Lasan-Perera/Fully-Analogue-Line-Follower-EN2091-/Final Schemetic.pdf

# LEFT PWM

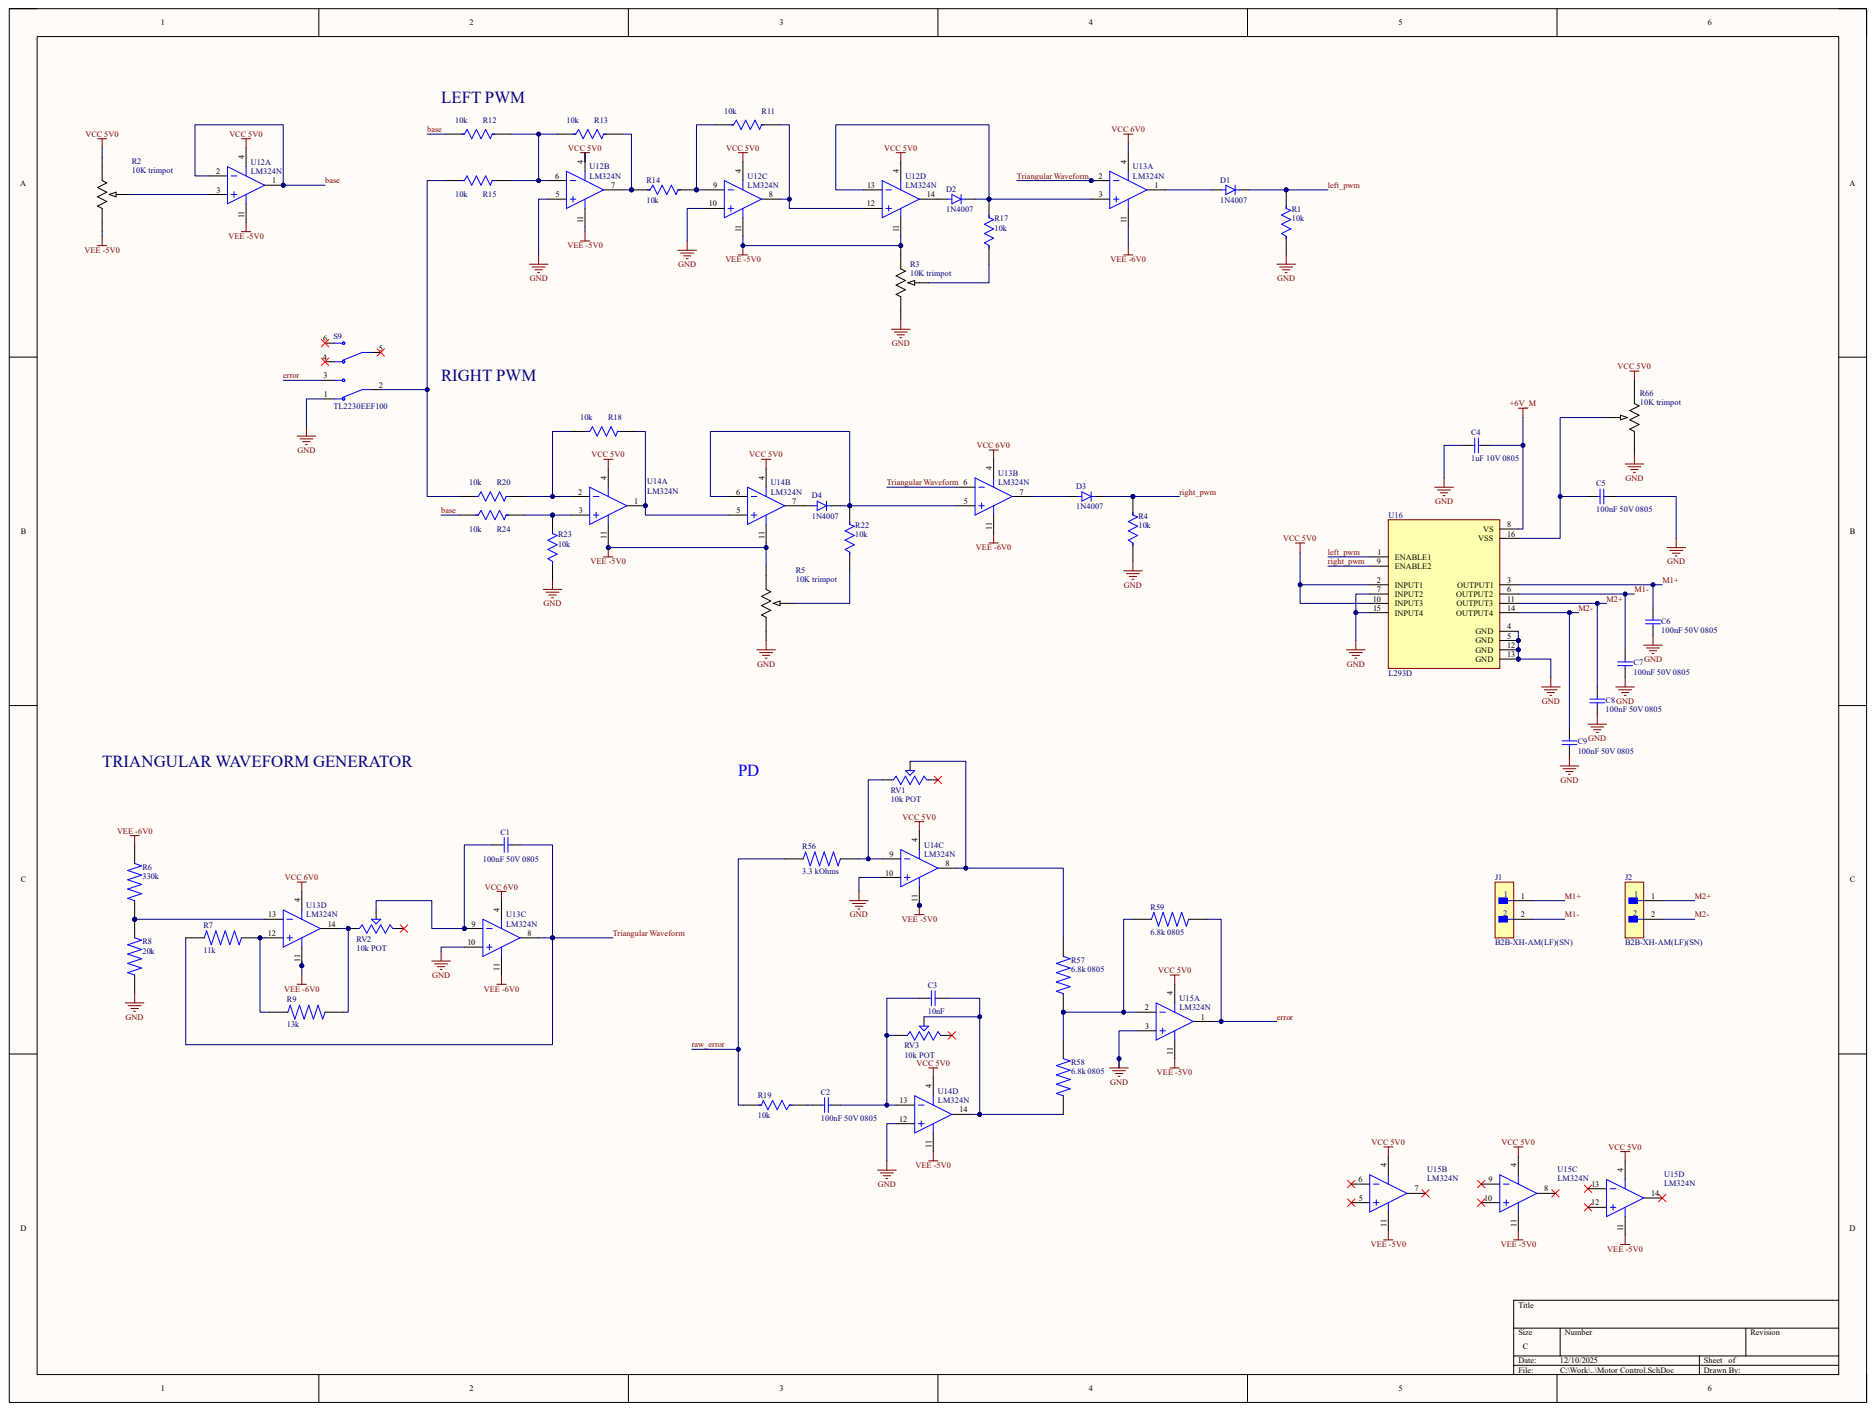
[picture p1: page 1]

A A

IN 1 | OUT | 3

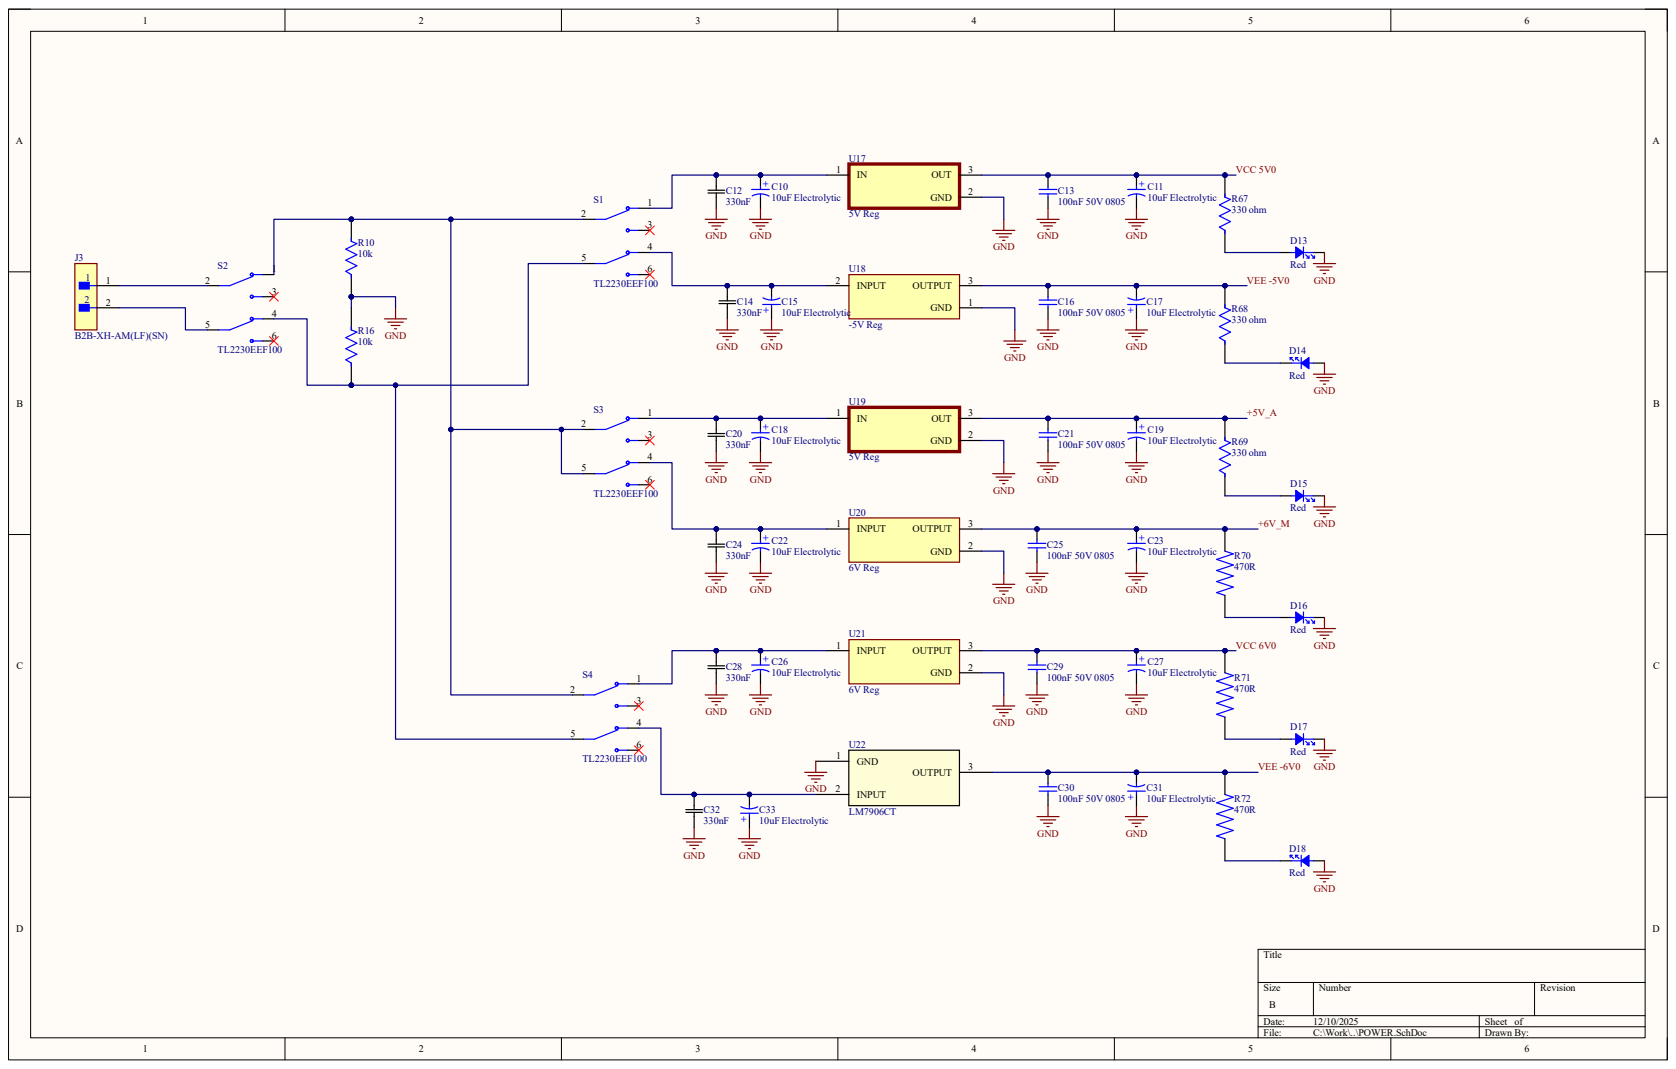
[picture p2: page 2]

# SENSOR PANEL +

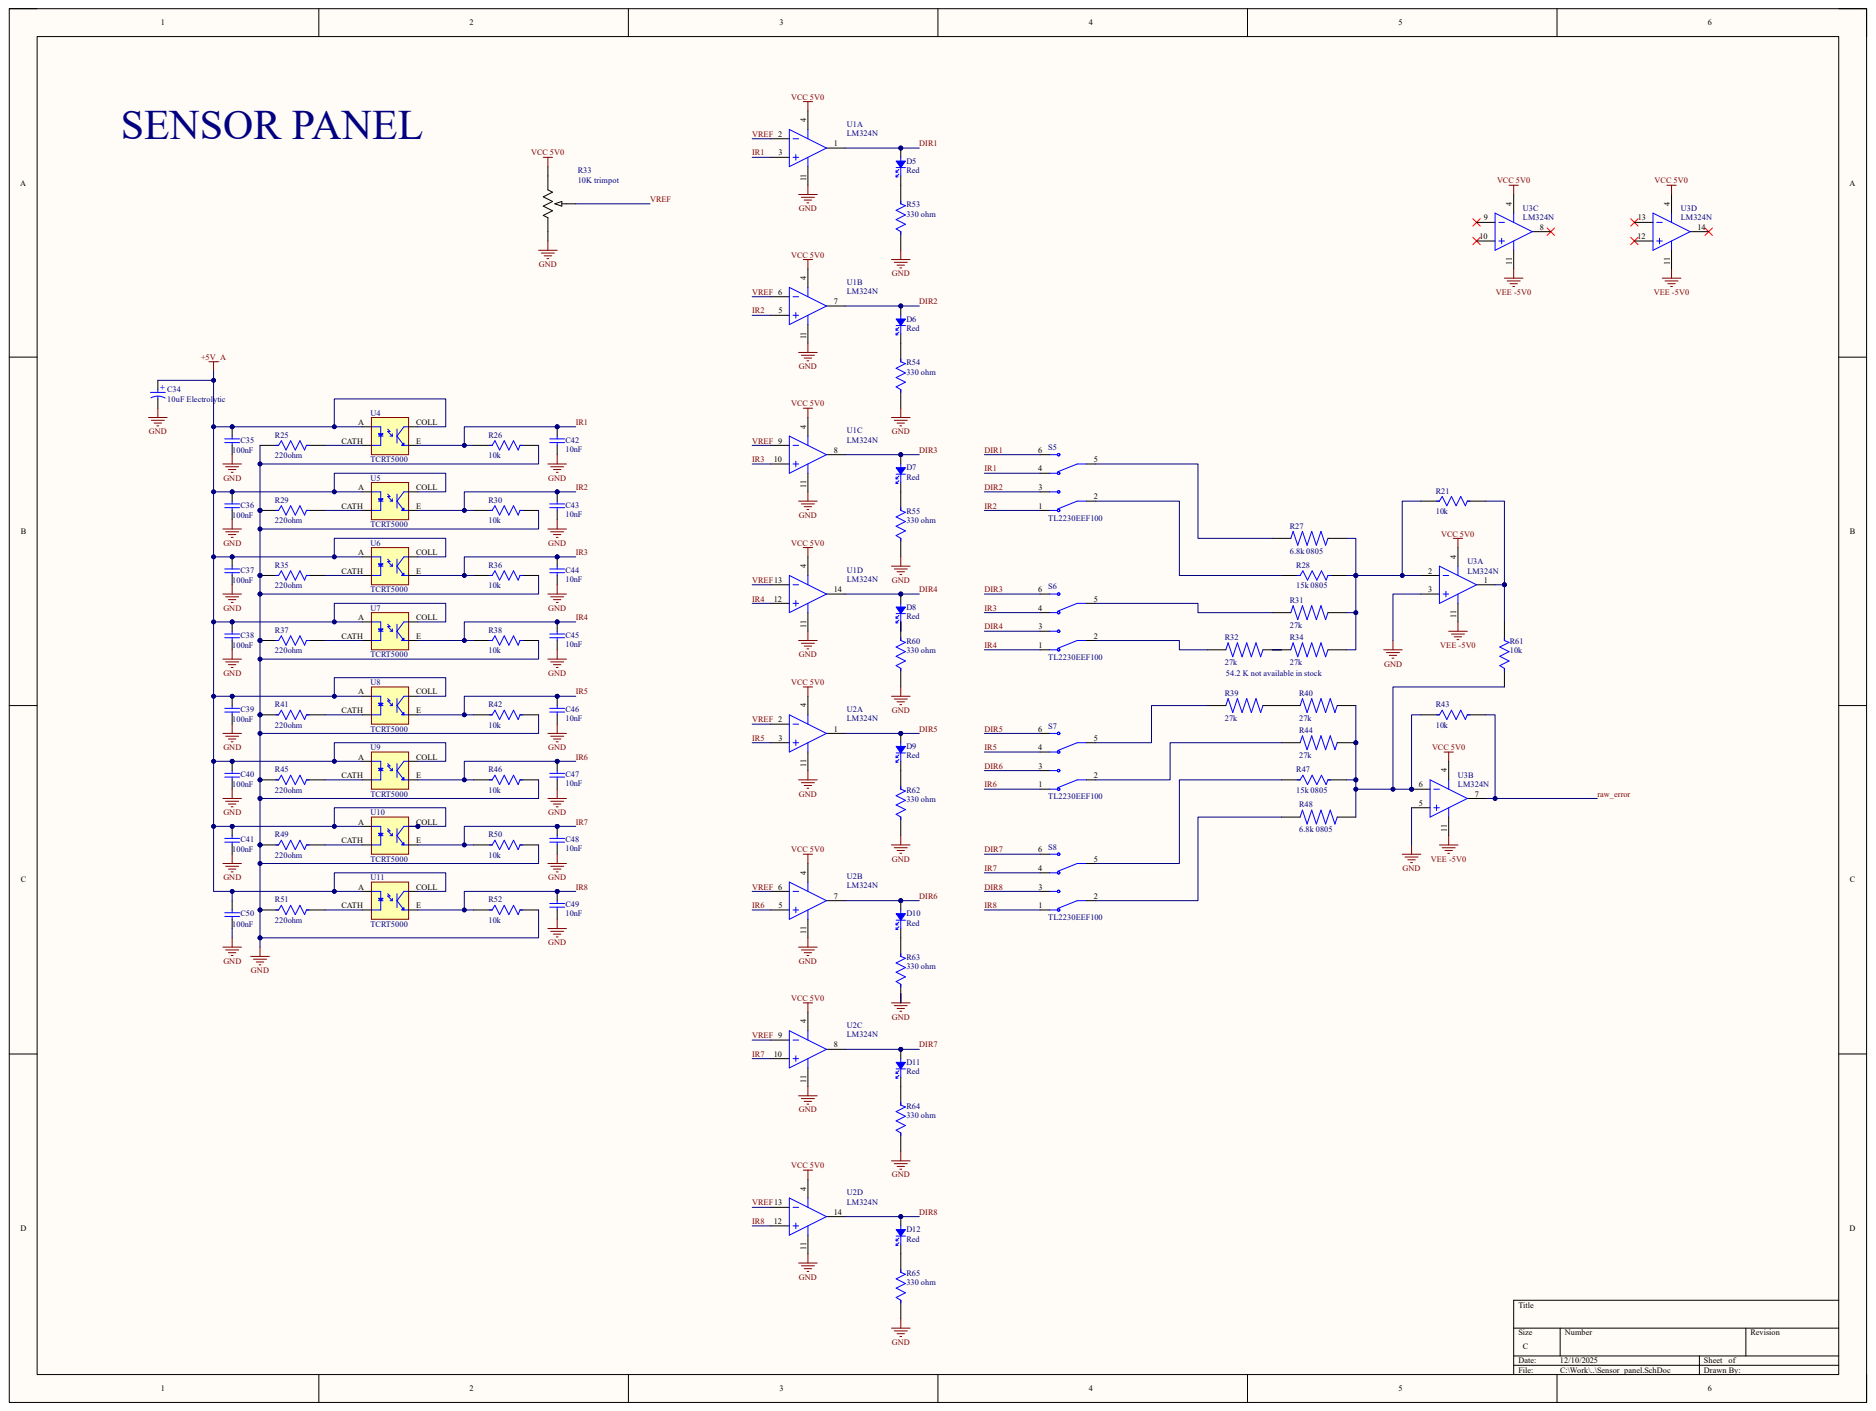
[picture p3: page 3]

54.2 K not available in stock
