Lasan-Perera/Fully-Analogue-Line-Follower-EN2091-/Simulations/Sensor Panel.pdf

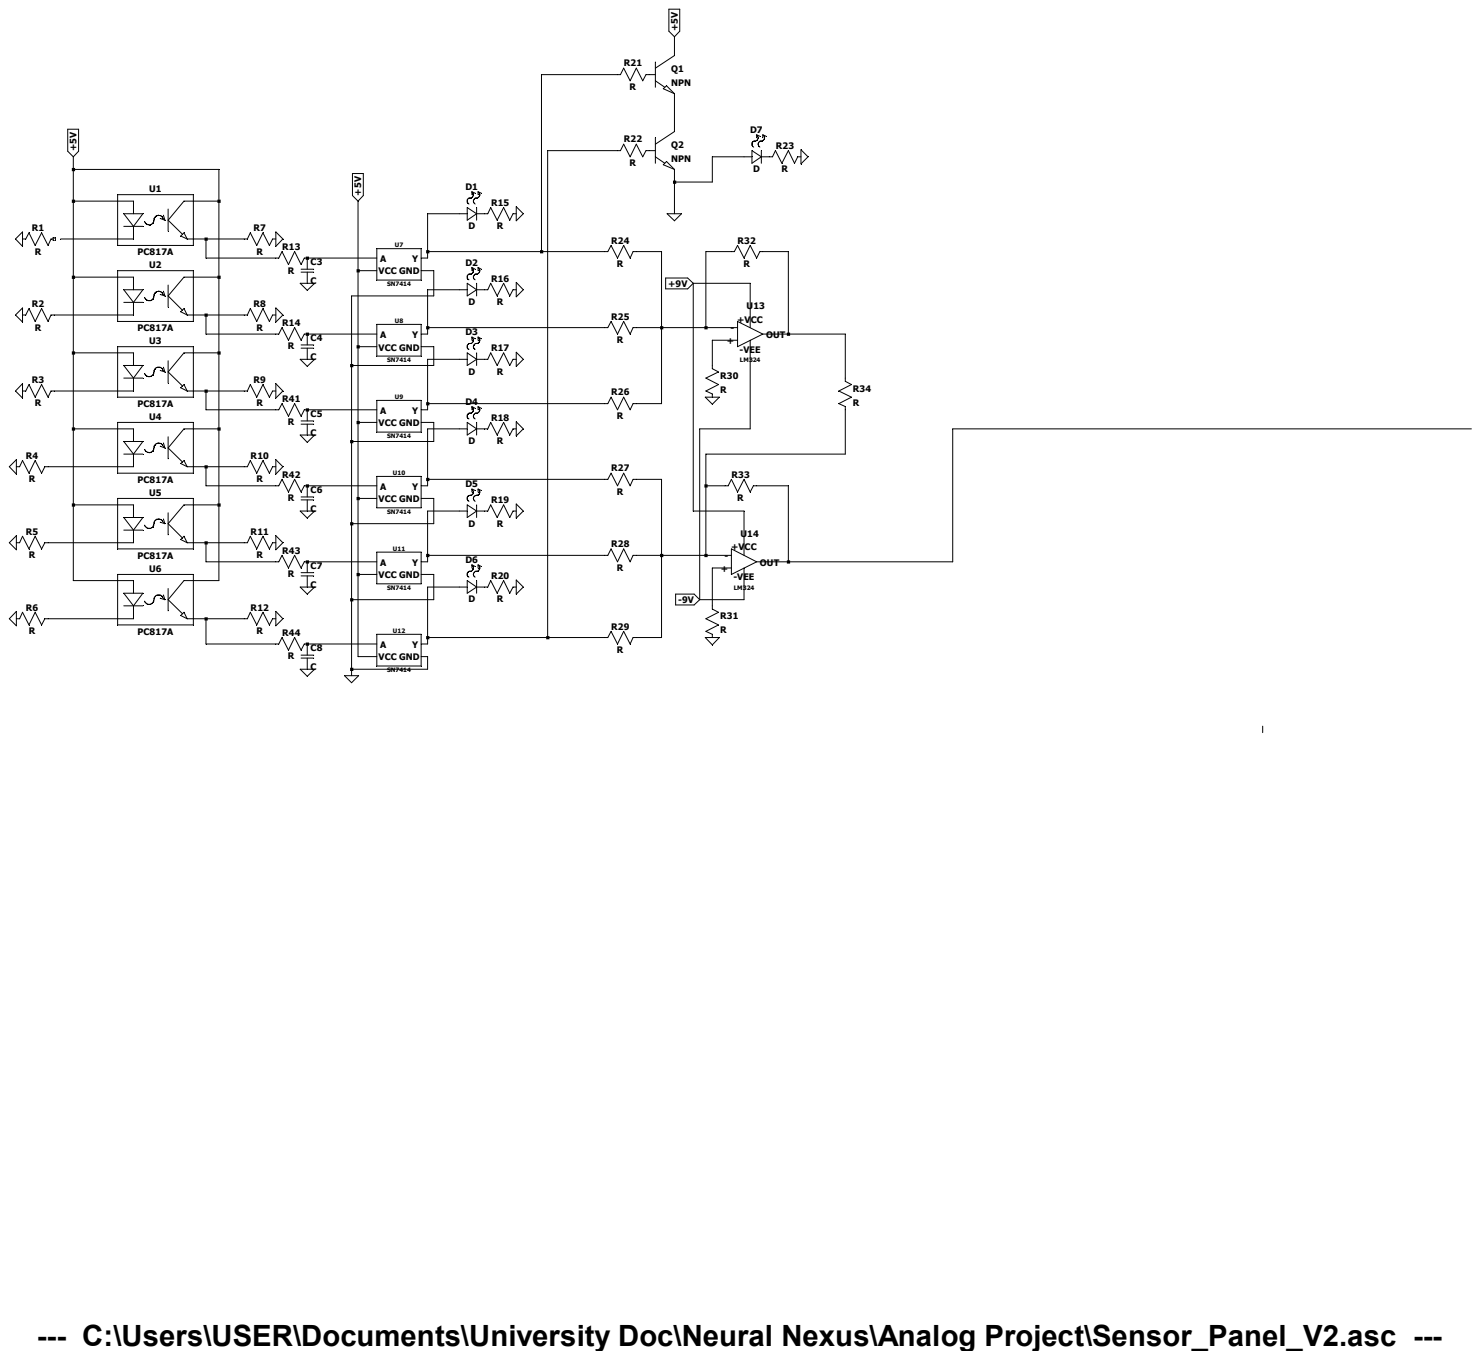
[picture p4: page 1]

--- C:\Users\USER\Documents\University Doc\Neural Nexus\Analog Project\Sensor_Panel_V2.asc ---
