Lasan-Perera/Fully-Analogue-Line-Follower-EN2091-/Simulations/PID System.asc

C1: cap; 0.1µ
C2: cap; 0.1µ
R1: res; 10k
R2: res; 10k
R3: res
R4: res; 10k
R5: res; 10k
R6: res; 10k
R7: res; 10k
R8: res; 10k
R9: res; 10k
R10: res; 10k
R11: res; 10k
U1: LMX24_LM2902
U2: LMX24_LM2902
U3: LMX24_LM2902
V1: voltage; 9v
V2: voltage; 9v
V3: voltage; 9v
V4: voltage; 9v
V5: voltage; 9v
V6: voltage; 9v
Named nets: 0
