Lasan-Perera/Fully-Analogue-Line-Follower-EN2091-/Simulations/Sensor_Panel.asc

D1: LED
* TCRT5000 Simple Model
.subckt TCRT5000 LED+ LED- C E PARAMS: DIST=0.5
* IR LED
Dled LED+ LED- Dmodel
Rled LED+ LED- 10
 
* Phototransistor (NPN)
Q1 C B E QNPN
Gb B E value = {1m*exp(-DIST/0.2)} ; photocurrent vs distance
 
.model Dmodel D(Is=1e-14 N=1.7)
.model QNPN NPN(Bf=100 Is=1e-14)
.ends TCRT5000
