Lasan-Perera/Fully-Analogue-Line-Follower-EN2091-/Simulations/Sensor_Panel_V2.asc

C3: cap
C4: cap
C5: cap
C6: cap
C7: cap
C8: cap
D1: LED
D2: LED
D3: LED
D4: LED
D5: LED
D6: LED
D7: LED
Q1: npn
Q2: npn
R1: res
R2: res
R3: res
R4: res
R5: res
R6: res
R7: res
R8: res
R9: res
R10: res
R11: res
R12: res
R13: res
R14: res
R15: res
R16: res
R17: res
R18: res
R19: res
R20: res
R21: res
R22: res
R23: res
R24: res
R25: res
R26: res
R27: res
R28: res
R29: res
R30: res
R31: res
R32: res
R33: res
R34: res
R41: res
R42: res
R43: res
R44: res
U1: PC817A
U2: PC817A
U3: PC817A
U4: PC817A
U5: PC817A
U6: PC817A
U7: SN7414
U8: SN7414
U9: SN7414
U10: SN7414
U11: SN7414
U12: SN7414
U13: LMX24_LM2902
U14: LMX24_LM2902
Named nets: +5V, 0, +9V, -9V, Error
