Lasan-Perera/Fully-Analogue-Line-Follower-EN2091-/(list of files, drawings)

Other design files:
Simulations/LTSpice_Models/sglm009d/lmx24_lm2902.dsn
Simulations/LTSpice_Models/sglm009d/lmx24_lm2902.opj
